Lamport-Robotics/pincer1/brain/corpus/fixtures/gpl/copyleft.md

# A copyleft document

This file is listed under a GPL-3.0 source and must never appear in the output, whatever it
says about scams, phishing, wallets or anything else. The collector reports the skip by licence
and moves on. It is long enough to pass the length filter and English enough to pass the
language filter, which is the point: only the licence keeps it out of the corpus.
