Lamport-Robotics/pincer1/brand/display-800x480.png

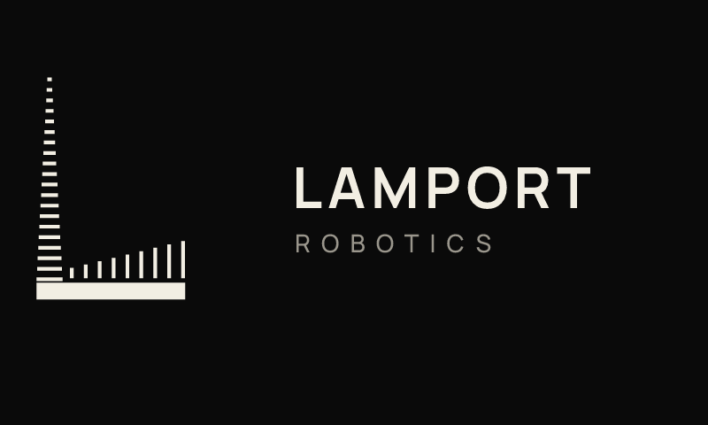
brand/display-800x480.png
