Lamport-Robotics/pincer1/brand/mark-128.png

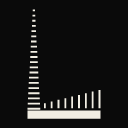
brand/mark-128.png
