Lamport-Robotics/pincer1/brand/og-1200x630.png

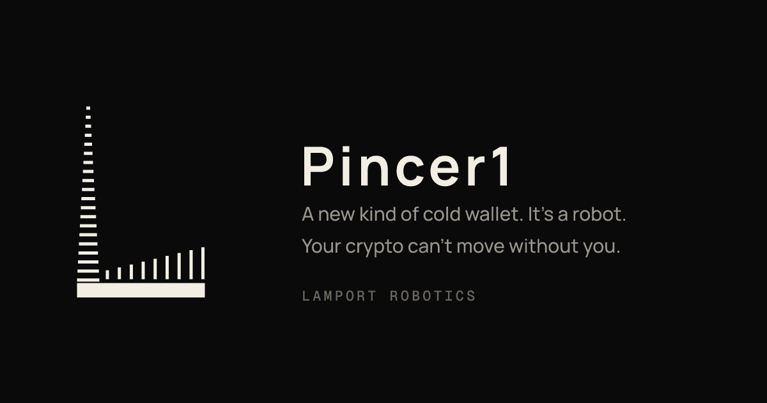
brand/og-1200x630.png
