Lamport-Robotics/pincer1/cad/out/battery_tray.png

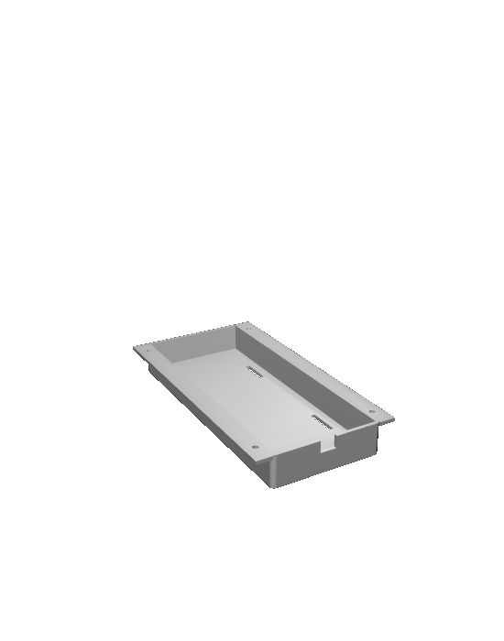
cad/out/battery_tray.png
