Lamport-Robotics/pincer1/cad/out/bottom_plate.png

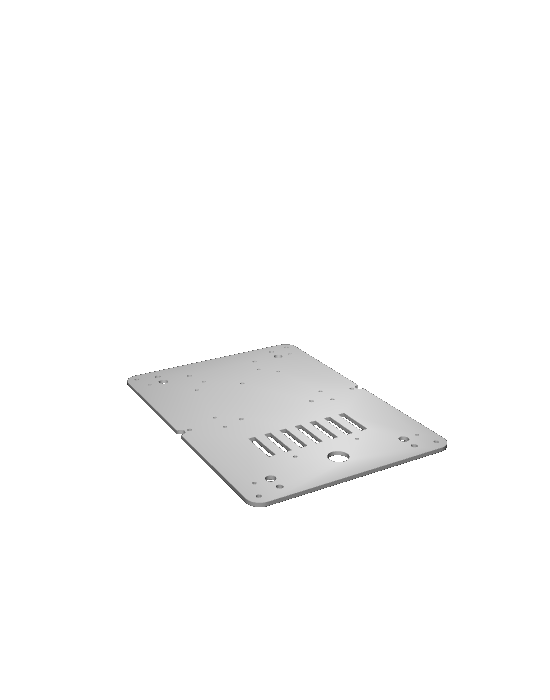
cad/out/bottom_plate.png
