Lamport-Robotics/pincer1/cad/out/camera_bracket.png

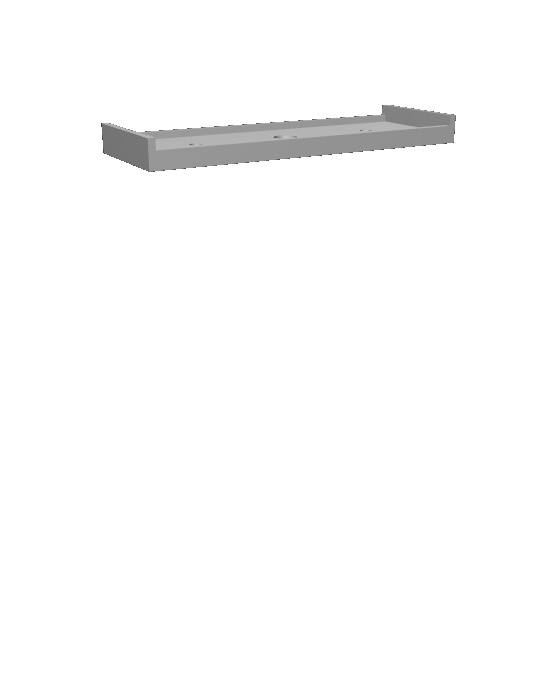
cad/out/camera_bracket.png
