Lamport-Robotics/pincer1/cad/out/coxa_bracket.png

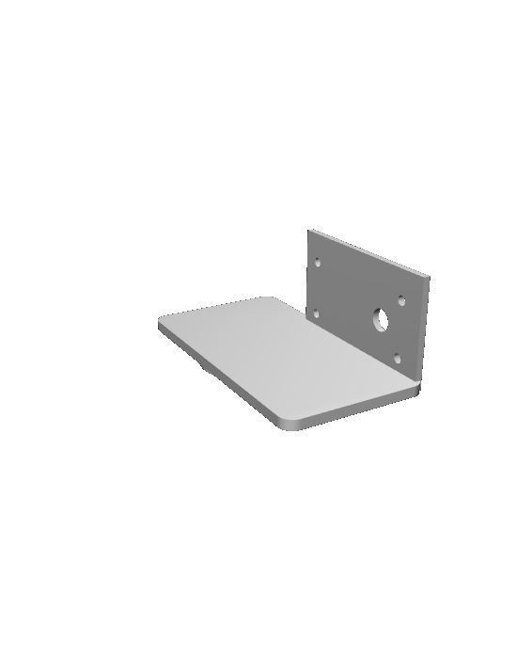
cad/out/coxa_bracket.png
