Lamport-Robotics/pincer1/cad/out/femur_link.png

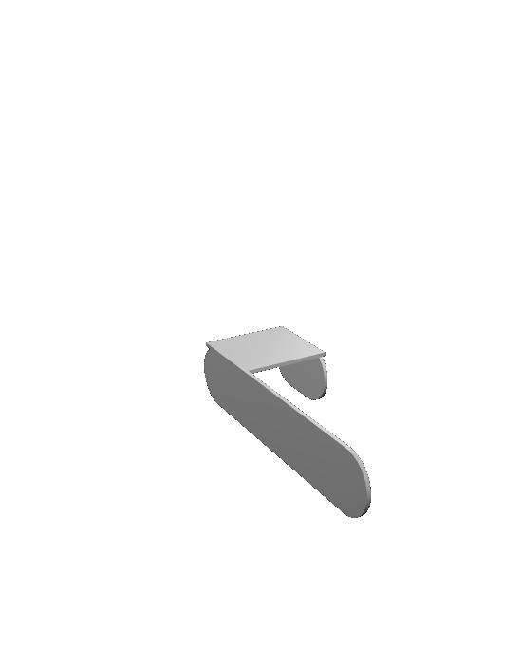
cad/out/femur_link.png
