Lamport-Robotics/pincer1/cad/out/front_bezel.png

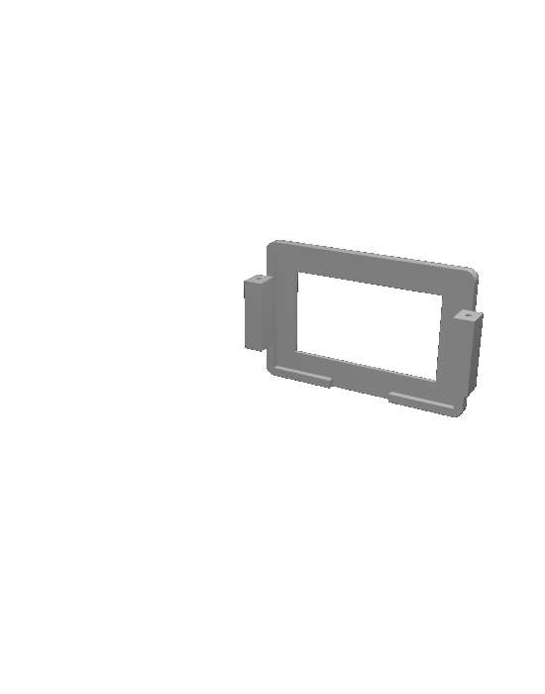
cad/out/front_bezel.png
