Lamport-Robotics/pincer1/cad/out/head_housing.png

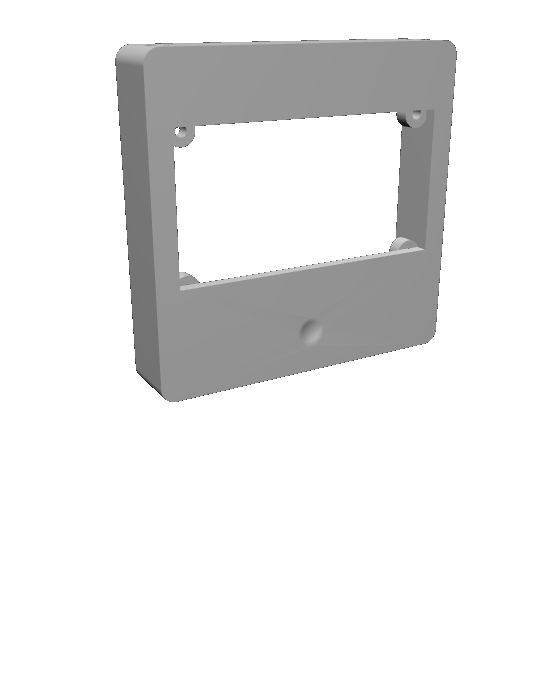
cad/out/head_housing.png
