Lamport-Robotics/pincer1/cad/out/tibia_link.png

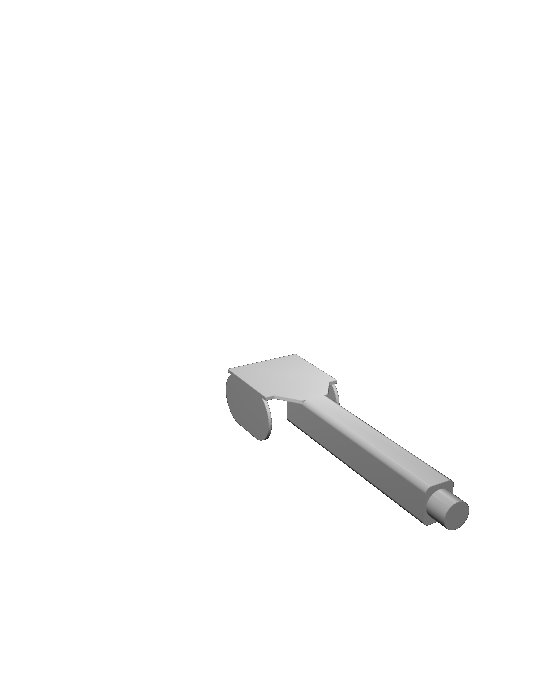
cad/out/tibia_link.png
