Lamport-Robotics/pincer1/cad/out/top_plate.png

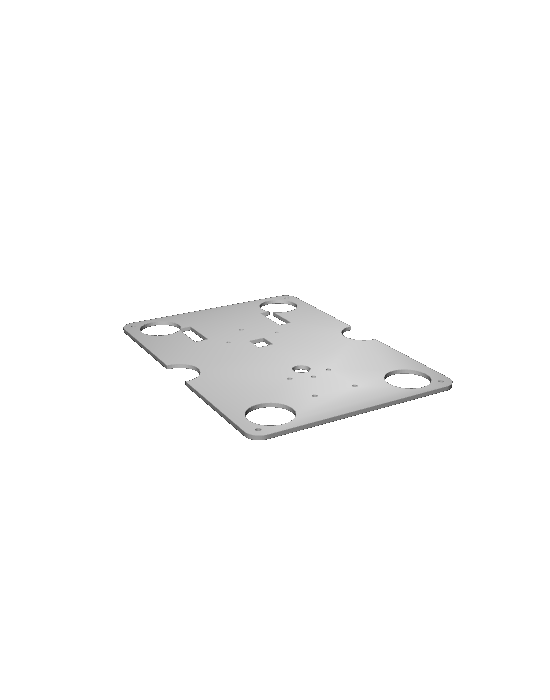
cad/out/top_plate.png
