Lamport-Robotics/pincer1/cad/out/wrist_adapter.png

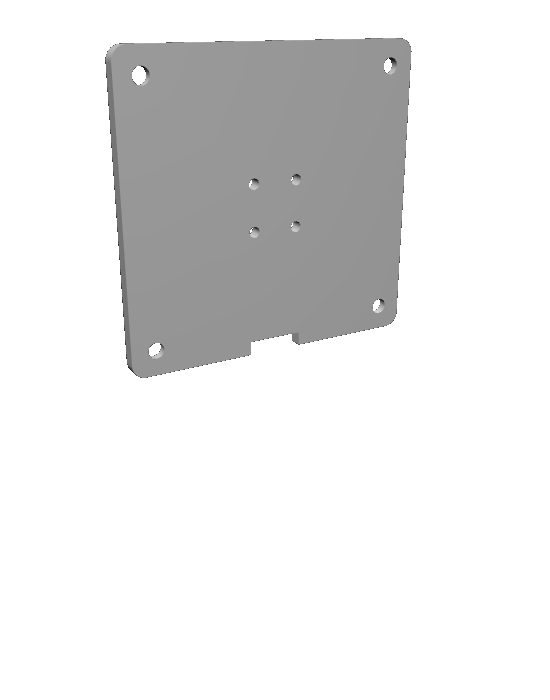
cad/out/wrist_adapter.png
