Lamport-Robotics/pincer1/sim/pincer1.png

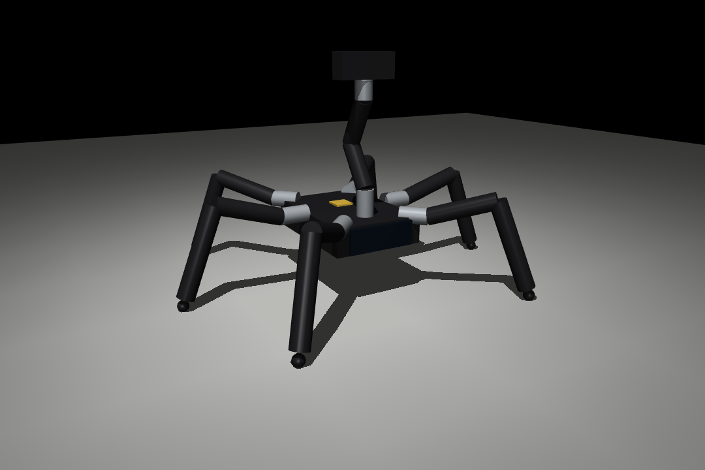
sim/pincer1.png
