Lamport-Robotics/pincer1/sim/stairs.gif

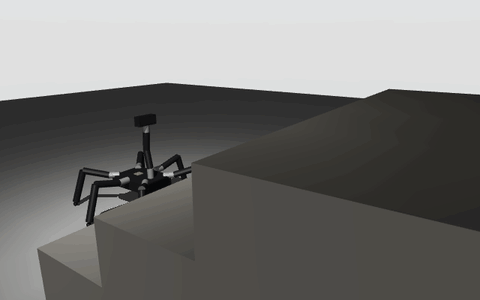
sim/stairs.gif
