Lamport-Robotics/pincer1/cad/out/bottom_plate.step

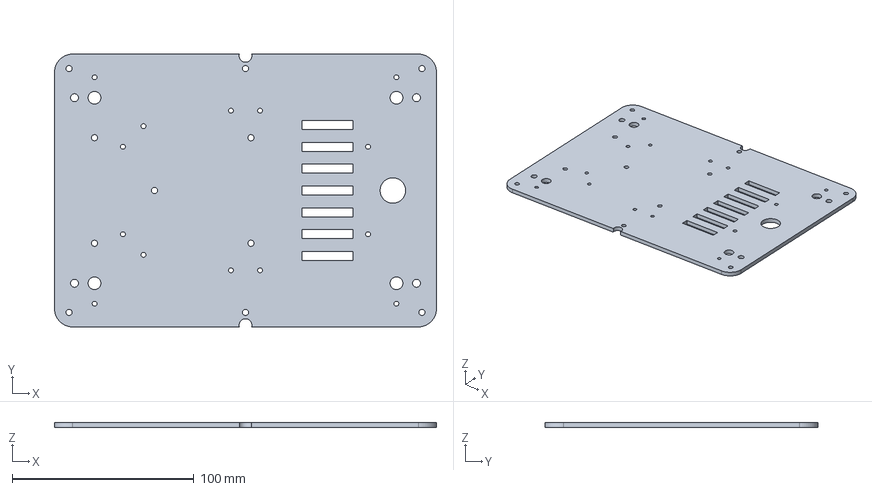
[picture p19: CAD file, 2026-11-01]
cad/out/bottom_plate.step
210.0 x 150.0 x 3.00 mm
