Lamport-Robotics/pincer1/cad/out/coxa_bracket.step

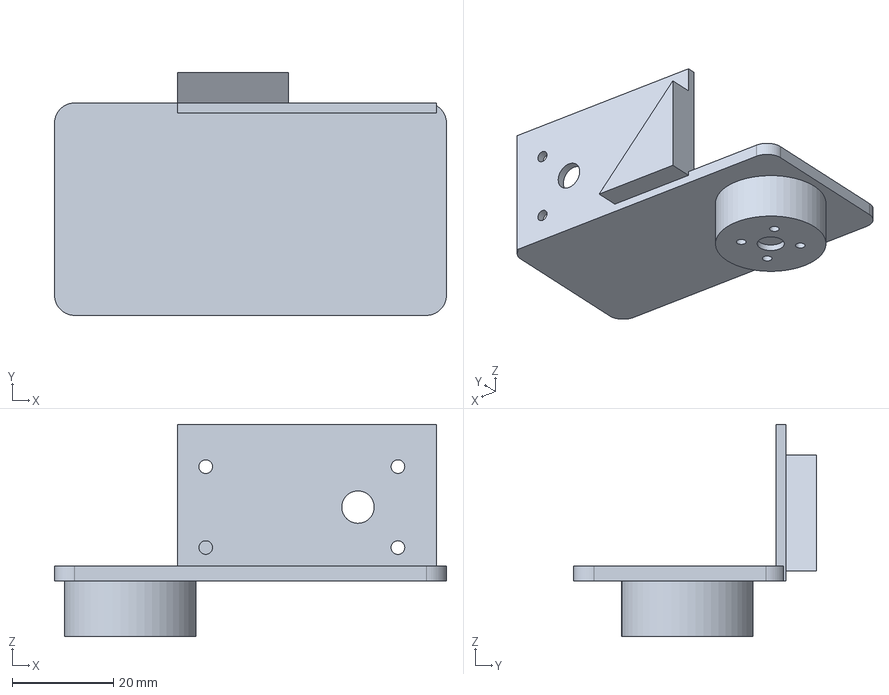
[picture p20: CAD file, 2026-11-01]
cad/out/coxa_bracket.step
77.5 x 48.0 x 42.0 mm
