Lamport-Robotics/pincer1/cad/out/top_plate.step

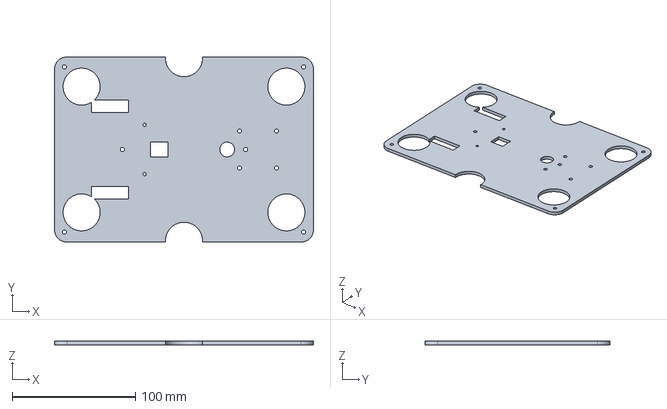
[picture p21: CAD file, 2026-11-01]
cad/out/top_plate.step
210.0 x 150.0 x 3.00 mm
