Lamport-Robotics/pincer1/cad/out/tibia_link.step

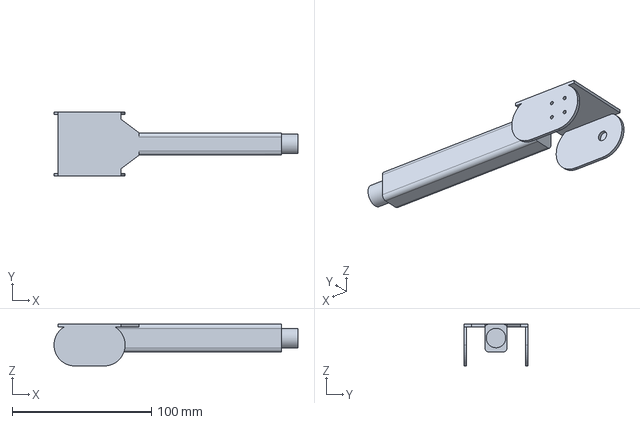
[picture p22: CAD file, 2026-11-01]
cad/out/tibia_link.step
175.0 x 46.0 x 30.0 mm
