Lamport-Robotics/pincer1/cad/out/femur_link.step

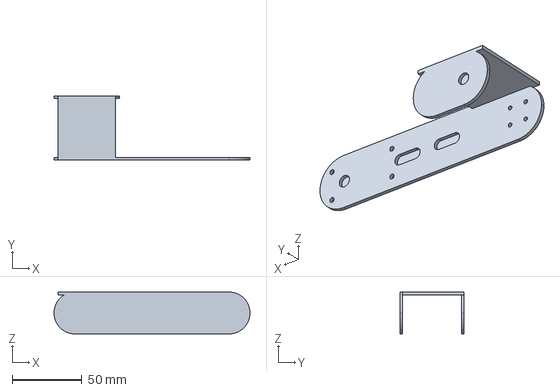
[picture p23: CAD file, 2026-11-01]
cad/out/femur_link.step
140.5 x 46.0 x 30.0 mm
