Lamport-Robotics/pincer1/cad/out/battery_tray.step

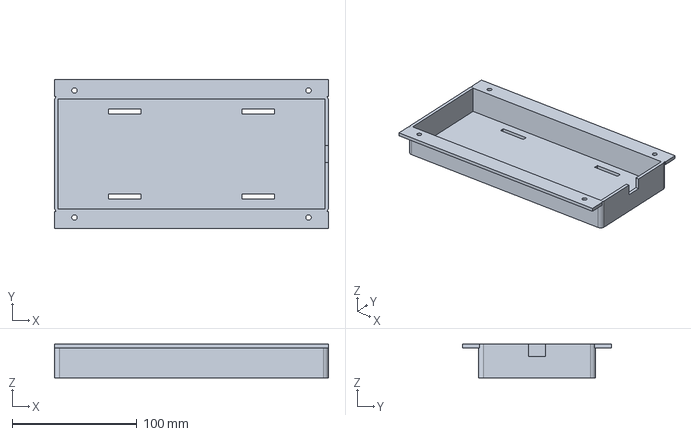
[picture p24: CAD file, 2026-11-01]
cad/out/battery_tray.step
220.0 x 120.0 x 27.0 mm
