Lamport-Robotics/pincer1/cad/out/front_bezel.step

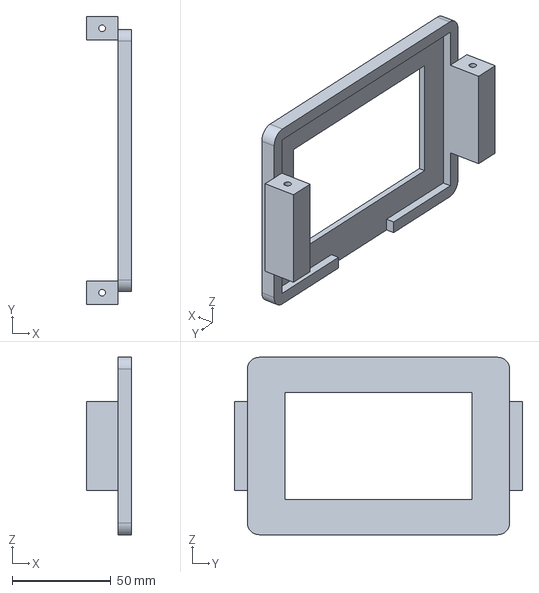
[picture p25: CAD file, 2026-11-01]
cad/out/front_bezel.step
23.0 x 146.0 x 90.0 mm
