Lamport-Robotics/pincer1/cad/out/camera_bracket.step

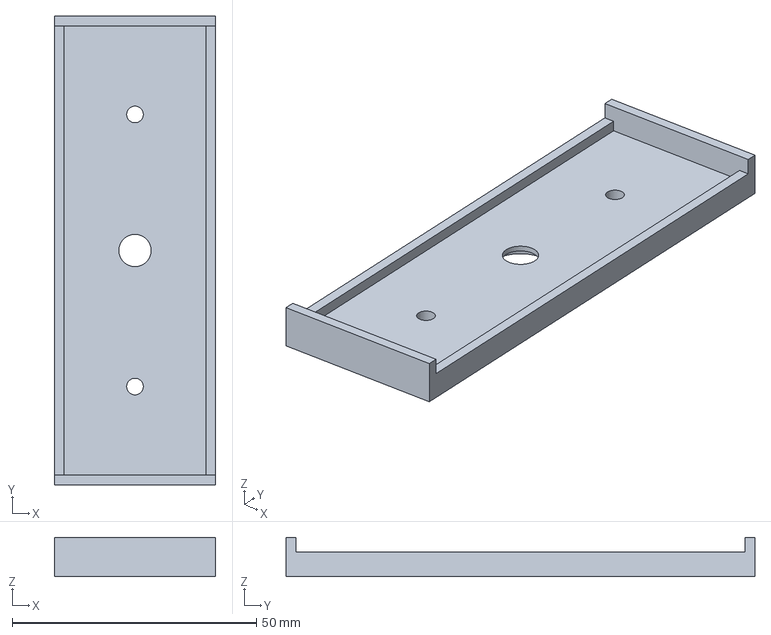
[picture p26: CAD file, 2026-11-01]
cad/out/camera_bracket.step
33.0 x 96.0 x 8.00 mm
