Lamport-Robotics/pincer1/cad/out/head_housing.step

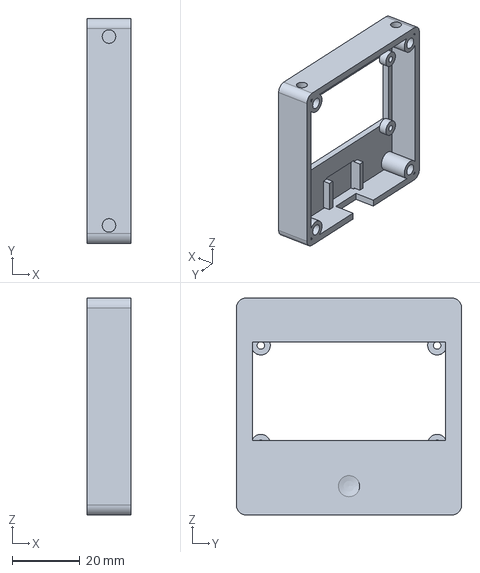
[picture p27: CAD file, 2026-11-01]
cad/out/head_housing.step
13.1 x 66.5 x 64.0 mm
