Lamport-Robotics/pincer1/cad/out/wrist_adapter.step

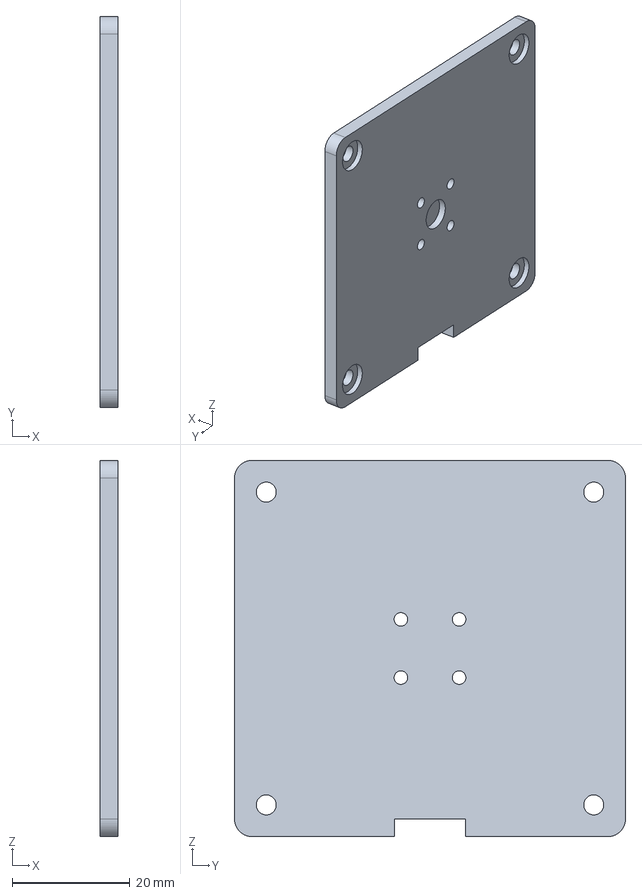
[picture p28: CAD file, 2026-11-01]
cad/out/wrist_adapter.step
3.00 x 66.5 x 64.0 mm
