Lamport-Robotics/pincer1/(list of files, cad)

Other CAD files:
cad/out/tibia_link_plate.dxf
cad/out/femur_link_plate.dxf
cad/out/battery_tray.stl
cad/out/bottom_plate.dxf
cad/out/bottom_plate.stl
cad/out/camera_bracket.stl
cad/out/coxa_bracket.stl
cad/out/femur_link.stl
cad/out/front_bezel.stl
cad/out/head_housing.stl
cad/out/tibia_link.stl
cad/out/top_plate.dxf
cad/out/top_plate.stl
cad/out/wrist_adapter.stl
