Lamport-Robotics/pincer1/cad/out/body_assembly.png

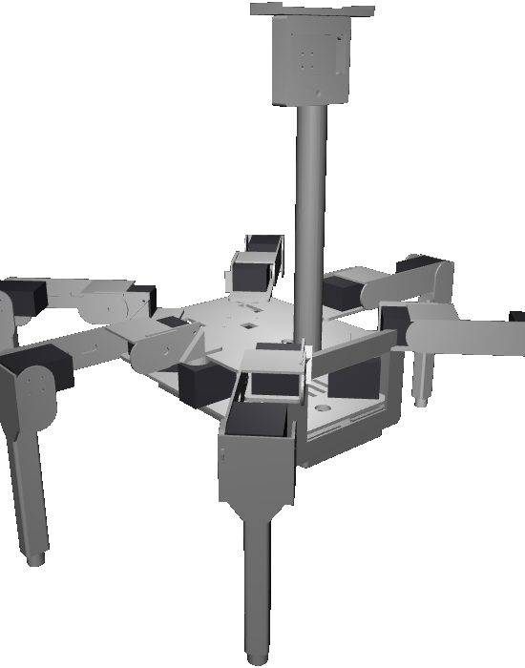
cad/out/body_assembly.png
