Lamport-Robotics/pincer1/cad/out/head_assembly.png

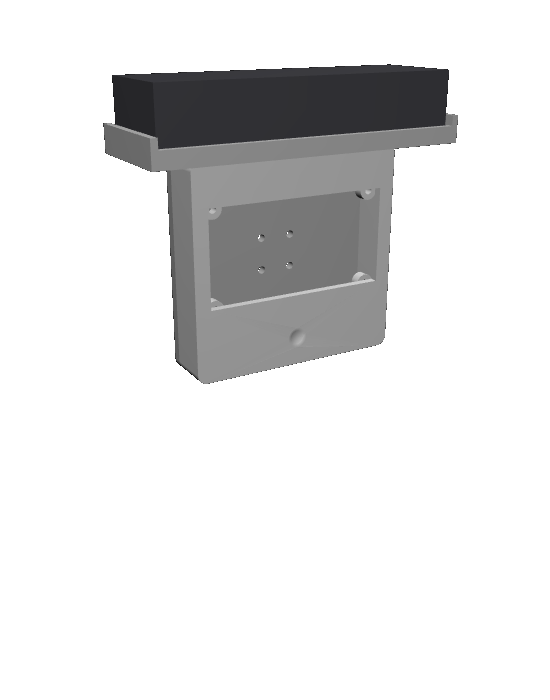
cad/out/head_assembly.png
