Lamport-Robotics/pincer1/robot/pincer_robot/body/controller.py

"""The body controller: velocity in, servo packets out, at a fixed tick.

``Body`` owns the geometry, the gait and the pose, and turns a ``Velocity`` command into joint
angles
for the eighteen leg servos. ``tick(dt)`` is the only thing that moves anything. Whatever drives the
servos (a ``Bus`` on the real body, a ``Simulation`` without one) is injected, so the same
controller
runs in tests, on a bench with a single leg, and on the robot.

``BodyBackend`` plugs this into the ``RobotInterface`` the rest of the service already uses
(walk / turn / attention / idle sway), replacing the external gait controller that backend talked
to.
"""

from __future__ import annotations

import logging
import math
import threading
import time
from collections.abc import Callable
from dataclasses import dataclass, field
from typing import Protocol

from ..motion import GAIT_SPEED_MPS, TURN_RATE_DPS, RobotInterface, RobotStatus
from .gait import GaitParams, GaitState, Velocity, feet_down, step
from .geometry import BodyGeometry
from .kinematics import BodyPose, JointAngles, ReachError, Vec3, solve_body
from .servo import Bus, ServoError
from .sim import Simulation

log = logging.getLogger("pincer.body")

TICK_HZ = 50.0


class Actuator(Protocol):
    """Where joint angles go. ``Bus.move`` on hardware; ``Simulation.apply`` without it."""

    def apply(self, angles: list[JointAngles]) -> None: ...


class BusActuator:
    """Maps the six legs' angles to servo ids and sends one sync-write per tick."""

    def __init__(self, bus: Bus, geometry: BodyGeometry, move_time_ms: int = 0):
        self.bus, self.geometry, self.move_time_ms = bus, geometry, move_time_ms

    def servo_ids(self) -> list[int]:
        return [sid for leg in range(6) for sid in self.geometry.servo_ids(leg)]

    def apply(self, angles: list[JointAngles]) -> None:
        targets: dict[int, float] = {}
        for leg, a in enumerate(angles):
            c, f, t = self.geometry.servo_ids(leg)
            targets[c], targets[f], targets[t] = a.coxa, a.femur, a.tibia
        self.bus.move(targets, time_ms=self.move_time_ms)

    def torque(self, on: bool) -> None:
        self.bus.torque(self.servo_ids(), on)


@dataclass
class Body:
    geometry: BodyGeometry = field(default_factory=BodyGeometry)
    gait: GaitParams = field(default_factory=GaitParams)
    actuator: Actuator | None = None
    pose: BodyPose = field(default_factory=BodyPose)
    command: Velocity = field(default_factory=Velocity)
    state: GaitState = field(default_factory=GaitState)
    sit_height_m: float = 0.035
    angles: list[JointAngles] = field(default_factory=list)
    feet: list[Vec3] = field(default_factory=list)
    _height: float | None = None

    def __post_init__(self) -> None:
        if self._height is None:
            self._height = self.geometry.stance_height_m

    # --- commands -----------------------------------------------------------------------
    def set_velocity(self, vx: float, vy: float = 0.0, wz: float = 0.0) -> None:
        self.command = Velocity(vx, vy, wz)

    def stop(self) -> None:
        self.command = Velocity()

    def set_pose(self, pose: BodyPose) -> None:
        self.pose = pose

    def set_height(self, height_m: float) -> None:
        lo, hi = self.sit_height_m, self.geometry.reach_m * 0.8
        self._height = max(lo, min(hi, height_m))

    # --- the tick -----------------------------------------------------------------------
    def targets(self, dt: float) -> list[JointAngles]:
        """Advance the gait by ``dt`` and compute the joint angles, without sending them."""
        feet = step(self.geometry, self.state, self.command, self.gait, dt)
        dz = self.geometry.stance_height_m - (self._height or self.geometry.stance_height_m)
        feet = [(x, y, z + dz) for x, y, z in feet]
        self.feet = feet
        self.angles = solve_body(self.geometry, feet, self.pose)
        return self.angles

    def tick(self, dt: float = 1.0 / TICK_HZ) -> list[JointAngles]:
        angles = self.targets(dt)
        if self.actuator is not None:
            self.actuator.apply(angles)
        return angles

    def feet_down(self) -> list[bool]:
        return feet_down(self.state, self.gait)

    def stand(self, seconds: float = 1.0, actuate: bool = True) -> None:
        """Rise from wherever the legs are to the neutral stance over ``seconds``."""
        self.stop()
        self.set_height(self.geometry.stance_height_m)
        self._settle(seconds, actuate)

    def sit(self, seconds: float = 1.0, actuate: bool = True) -> None:
        self.stop()
        self.set_height(self.sit_height_m)
        self._settle(seconds, actuate)

    def _settle(self, seconds: float, actuate: bool) -> None:
        n = max(1, int(seconds * TICK_HZ))
        for _ in range(n):
            self.tick(1.0 / TICK_HZ) if actuate else self.targets(1.0 / TICK_HZ)
            if actuate and self.actuator is not None:
                time.sleep(1.0 / TICK_HZ)


@dataclass
class HealthReport:
    hottest_c: int = 0
    heaviest_load: int = 0
    unreadable: list[int] = field(default_factory=list)
    over: list[str] = field(default_factory=list)  # "servo 7 at 74 C", "servo 12 load 910"

    @property
    def ok(self) -> bool:
        return not self.over


class ServoHealth:
    """Temperature and load of every joint, read over the bus between gait ticks. Past a
    threshold the body is put in cooldown: nothing walks until it expires, and the reason is
    logged once per episode rather than on every poll."""

    def __init__(
        self,
        bus: Bus,
        servo_ids: list[int],
        *,
        max_temp_c: int = 70,
        max_load: int = 800,
        cooldown_s: float = 30.0,
        clock=time.monotonic,
    ):
        self.bus, self.ids = bus, list(servo_ids)
        self.max_temp_c, self.max_load, self.cooldown_s = max_temp_c, max_load, cooldown_s
        self._clock = clock
        self.cooldown_until = 0.0
        self.last: HealthReport = HealthReport()
        self._announced = False

    def check(self) -> HealthReport:
        r = HealthReport()
        for sid in self.ids:
            try:
                t = self.bus.temperature(sid)
                ld = abs(self.bus.load(sid))
            except ServoError:
                r.unreadable.append(sid)
                continue
            r.hottest_c = max(r.hottest_c, t)
            r.heaviest_load = max(r.heaviest_load, ld)
            if t >= self.max_temp_c:
                r.over.append(f"servo {sid} at {t} C")
            if ld >= self.max_load:
                r.over.append(f"servo {sid} load {ld}")
        self.last = r
        if r.over:
            self.cooldown_until = self._clock() + self.cooldown_s
            if not self._announced:
                log.warning("body: %s; resting %.0f s", ", ".join(r.over), self.cooldown_s)
                self._announced = True
        elif self._announced and not self.in_cooldown():
            log.info("body: servos back within limits")
            self._announced = False
        if len(r.unreadable) == len(self.ids) and self.ids:
            log.warning("body: no servo answered the health poll")
        return r

    def in_cooldown(self) -> bool:
        return self._clock() < self.cooldown_until


class SensorSource(Protocol):
    """Where tilt and clearance come from when the gait is ours (ros_backend.SensorNode)."""

    def shutdown(self) -> None: ...


class BodyBackend(RobotInterface):
    """The service's robot: drives ``Body`` from the normalised Twist the motion layer produces.
    ``status`` is shared with the sensor source, which writes tilt and front clearance into it;
    ``health`` gates every drive on the last servo poll."""

    def __init__(
        self,
        body: Body,
        status: RobotStatus | None = None,
        *,
        sensors: SensorSource | None = None,
        health: ServoHealth | None = None,
        drive: Callable[[float, float, float], None] | None = None,
    ):
        self.body = body
        self._status = status or RobotStatus(note="body: own gait")
        self.sensors = sensors
        self.health = health
        # a locomotion controller that is not ours (the chassis' own gait): (lin_x, ang_z, seconds)
        self.drive_fn = drive
        self._lock = threading.Lock()
        self._moving = False
        self._poll: threading.Thread | None = None
        self._poll_stop = threading.Event()

    def get_status(self) -> RobotStatus:
        self._status.is_moving = self._moving
        return self._status

    # --- health -------------------------------------------------------------------------
    def start_health_poll(self, period_s: float) -> None:
        if self.health is None or period_s <= 0 or self._poll is not None:
            return
        self._poll = threading.Thread(target=self._poll_loop, args=(period_s,), daemon=True)
        self._poll.start()

    def _poll_loop(self, period_s: float) -> None:
        while not self._poll_stop.wait(period_s):
            with self._lock:  # never interleave reads with a gait tick's sync-write
                self.health.check()  # type: ignore[union-attr]

    def resting(self) -> str | None:
        """Why the body will not walk right now, or None."""
        if self.health is not None and self.health.in_cooldown():
            return "; ".join(self.health.last.over) or "servo cooldown"
        return None

    def shutdown(self) -> None:
        self._poll_stop.set()
        self.stop()
        if self.sensors is not None:
            self.sensors.shutdown()

    def _drive(self, lin_x: float, ang_z: float, duration_s: float) -> None:
        why = self.resting()
        if why is not None:
            log.warning("body: not moving (%s)", why)
            return
        if self.drive_fn is not None:
            with self._lock:
                self._moving = True
                try:
                    self.drive_fn(lin_x, ang_z, duration_s)
                finally:
                    self._moving = False
            return
        with self._lock:
            self._moving = True
            self.body.set_velocity(lin_x * GAIT_SPEED_MPS, 0.0, math.radians(ang_z * TURN_RATE_DPS))
            end = time.monotonic() + duration_s
            period = 1.0 / TICK_HZ
            try:
                while time.monotonic() < end:
                    t0 = time.monotonic()
                    try:
                        self.body.tick(period)
                    except ReachError as e:  # a pose the legs cannot hold: stop rather than fold
                        log.warning("body: %s; stopping", e)
                        break
                    time.sleep(max(0.0, period - (time.monotonic() - t0)))
            finally:
                self.body.stop()
                # let the feet come down before reporting still
                for _ in range(int(self.body.gait.cycle_s * TICK_HZ)):
                    self.body.tick(period)
                    if all(self.body.feet_down()):
                        break
                    time.sleep(period)
                self._moving = False

    def climb(
        self,
        riser_m: float,
        tread_m: float = 0.28,
        steps: int = 1,
        *,
        distance_m: float | None = None,
        yaw_rad: float | None = None,
        sleep: Callable[[float], None] = time.sleep,
    ) -> str:
        """Square up to the first riser, close in to the cycle's standoff, then play the stair
        cycle from ``climb.py`` at the gait tick. Refused with the planner's reason when the
        geometry cannot do the riser, or when the body is resting."""
        from .climb import (
            ClimbError,
            ClimbParams,
            Terrain,
            angles_at,
            climb_cycle,
            duration,
            interpolate,
        )

        why = self.resting()
        if why is not None:
            return f"REFUSED: not climbing ({why})."
        if self._status.tilt_deg > 10.0:
            return f"REFUSED: body tilted {self._status.tilt_deg:.0f} deg before the stairs."
        params = ClimbParams(riser_m=riser_m, tread_m=tread_m, steps=max(1, int(steps)))
        try:
            keyframes = climb_cycle(self.body.geometry, params)
        except ClimbError as e:
            return f"REFUSED: {e.phase}: {e.reason}."
        notes: list[str] = []
        if yaw_rad is not None and abs(yaw_rad) > math.radians(3.0):
            notes.append(
                self.turn("left" if yaw_rad > 0 else "right", abs(math.degrees(yaw_rad)), speed=0.4)
            )
        if distance_m is not None:
            gap = distance_m - Terrain(riser_m, tread_m).edge0_m
            if gap > 0.02:
                notes.append(self.walk("forward", gap, speed=0.4))
            elif gap < -0.05:
                notes.append(self.walk("backward", -gap, speed=0.4))
        if any(n.startswith("REFUSED") for n in notes):
            return "; ".join(notes)
        period = 1.0 / TICK_HZ
        with self._lock:
            self._moving = True
            try:
                for feet, pose in interpolate(keyframes, period):
                    t0 = time.monotonic()
                    angles = angles_at(self.body.geometry, feet, pose)
                    self.body.angles = angles
                    if self.body.actuator is not None:
                        self.body.actuator.apply(angles)
                    sleep(max(0.0, period - (time.monotonic() - t0)))
            except ReachError as e:
                self.body.stop()
                return f"STOPPED: {e}"
            finally:
                self._moving = False
        self.body.stop()
        total = steps * riser_m
        return (
            f"OK: climbed {steps} step(s) of {riser_m * 100:.0f} cm, {total * 100:.0f} cm up, "
            f"in {duration(keyframes):.0f} s."
        )

    def stop(self) -> None:
        self.body.stop()
        stop = getattr(self.drive_fn, "__self__", None)
        if stop is not None and hasattr(stop, "stop"):
            stop.stop()
        self._moving = False


def simulated_body(
    geometry: BodyGeometry | None = None, gait: GaitParams | None = None
) -> tuple[Body, Simulation]:
    sim = Simulation(geometry or BodyGeometry())
    body = Body(geometry=sim.geometry, gait=gait or GaitParams(), actuator=sim)
    return body, sim
