Lamport-Robotics/pincer1/firmware/src/consent.c

#include "consent.h"

#include <string.h>

#include "util.h"

#define SECONDS_PER_DAY CONSENT_SECONDS_PER_DAY

static void copy_id(char *dst, const char *id)
{
    size_t n = id ? strlen(id) : 0;
    if (n >= CONSENT_ID_MAX) n = CONSENT_ID_MAX - 1;
    memcpy(dst, id, n);
    dst[n] = 0;
}

static void clear_pending(consent_t *c) { secure_zero(&c->pending, sizeof c->pending); }

static void clear_allowance(consent_t *c)
{
    if (c->p.allowance.active) c->dirty = true;
    memset(&c->p.allowance, 0, sizeof c->p.allowance);
}

/* Exchanges the active slot's limits and counters with the other slot's. Called when duress starts or
 * ends: the decoy slot keeps its own limits, so a policy request behaves the same in both slots. */
static void swap_slot_policy(consent_t *c)
{
    consent_persist_t *p = &c->p;
    uint64_t t64;
    u256_t t256;
    if (!p->duress && !p->shadow_valid) {
        /* first time into duress: the decoy starts with the real slot's limits (a decoy that allows nothing
         * convinces nobody) and a clean day; the owner may change them from inside the decoy later */
        p->shadow.daily_limit = p->daily_limit;
        p->shadow.daily_limit_wei = p->daily_limit_wei;
        p->shadow.daily_limit_sats = p->daily_limit_sats;
        p->shadow.spent_today = 0;
        u256_zero(&p->shadow.spent_today_wei);
        p->shadow.spent_today_sats = 0;
        p->shadow_valid = true;
    }
#define SWAP64(a, b) do { t64 = (a); (a) = (b); (b) = t64; } while (0)
#define SWAP256(a, b) do { t256 = (a); (a) = (b); (b) = t256; } while (0)
    SWAP64(p->daily_limit, p->shadow.daily_limit);
    SWAP64(p->spent_today, p->shadow.spent_today);
    SWAP256(p->daily_limit_wei, p->shadow.daily_limit_wei);
    SWAP256(p->spent_today_wei, p->shadow.spent_today_wei);
    SWAP64(p->daily_limit_sats, p->shadow.daily_limit_sats);
    SWAP64(p->spent_today_sats, p->shadow.spent_today_sats);
#undef SWAP64
#undef SWAP256
    c->dirty = true;
}

static void clear_elevate(consent_t *c) { memset(&c->elevate, 0, sizeof c->elevate); }

static bool time_reached(uint32_t now_ms, uint32_t deadline_ms)
{
    return (int32_t)(now_ms - deadline_ms) >= 0;
}

static consent_result_t deny(consent_reason_t r, consent_reason_t *why)
{
    if (why) *why = r;
    return CONSENT_R_DENIED;
}

void consent_init(consent_t *c, const consent_persist_t *persisted, uint32_t now_ms)
{
    memset(c, 0, sizeof *c);
    if (persisted) c->p = *persisted;
    /* A power cycle must never be a way around a lock: initialised controllers boot locked. */
    c->locked = c->p.initialized;
    c->tick_last_ms = now_ms;
}

void consent_init_inheritance(consent_t *c, const consent_inh_persist_t *persisted)
{
    memset(&c->ih, 0, sizeof c->ih);
    if (persisted) c->ih = *persisted;
    /* Resume, never rewind: the stored value is the floor from now on. */
    if (c->ih.last_touch_powered_seconds > c->ih.powered_seconds)
        c->ih.last_touch_powered_seconds = c->ih.powered_seconds;
    if (c->ih.inh.n_warn > CONSENT_INH_MAX_WARN) c->ih.inh.n_warn = CONSENT_INH_MAX_WARN;
    c->ih_persisted_seconds = c->ih.powered_seconds;
    c->ih_dirty = false;
}

/* ---- dead-man timer ---- */
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
