Lamport-Robotics/pincer1/(commit log)

2026-10-10 robot: lidar/face/voice fusion
2026-10-11 jetson deploy
2026-10-11 dock + battery
2026-10-12 wip: configs, room fingerprint tests
2026-10-14 daemon: pairing reply carries every chain's address
2026-10-20 body: leg geometry and closed-form kinematics
2026-10-20 body: tripod, ripple and wave gaits with per-leg landing on stop
2026-10-20 body: serial-bus servo driver, sync write, calibration
2026-10-20 body: controller at 50 hz, simulator with support-polygon check, backend for the motion layer
2026-10-21 firmware: update engine, staged image + trial ledger
2026-10-21 deploy: signed releases, switch, health check, rollback
2026-10-25 firmware: each key slot keeps its own limits; owner operations answer the same in both slots; storage v7
2026-10-25 robot: no browser on the socket, bounded tasks, map names checked, own speech ignored, duress latch clears, enrolment authenticated and 0600, spoken text kept out of logs
2026-10-27 firmware: flash records sealed with a device-derived mac, host time floor persisted
2026-10-27 extension: no raw tx relay, local fonts only, tighter csp
2026-10-27 beacon: radio arm and disarm still end an alarm
2026-10-27 beacon: pseudonymous packet ids on air, relay commands need a token
2026-10-27 robot: servo temperature and load polled, short replies are errors, lidar and imu from the bus backend
2026-10-27 deps: vitest 5, tsx with a current esbuild
2026-10-31 body: segment lengths and coxa positions as measured on the v1 chassis
2026-10-31 sim: pincer1 as urdf and mjcf, built from geometry.py, stance-checked in mujoco
2026-11-01 presence: face observations carry the frame height, y_norm beside x_norm
2026-11-01 body: gaze, the camera head follows the face and scans when it is gone
2026-11-01 robot: on the bus body the head is raised at start and steered from the presence loop
2026-11-01 docs: the head and the calibration procedure in body.md
2026-11-01 cad: the head as code, housing for the display and the consent pad, camera cradle, wrist adapter
2026-11-01 readme: cad is in here now
2026-11-01 robot: terrain, the floor ahead from the depth camera: height grid, first riser, clearance
2026-11-01 body: climb, a stair cycle from the kinematics: pulls, swings over the riser, body fit with pitch
2026-11-01 sim: stairs.py climbs box steps in mujoco; the 12 cm step as a gif
2026-11-01 body: v1 legs 110 / 160 mm, the length that takes a 17 cm stair; stance and camera height follow
2026-11-01 robot: depth source for the floor ahead, stereo from the head camera or a drawn scene; floor watch thread
2026-11-01 motion: a forward walk is refused where the depth camera says the floor ends
2026-11-01 sim: the shin stops short of the foot ball; the stance check holds with position servos
2026-11-01 body: the long legs walk at 0.30 m/s by default, 0.6 s cycle and 12 cm steps; walk.py sweeps speed and turn
2026-11-01 climb: belly clearance, wider support margin, staged level-out and paced keyframes; 13 cm stairs in mujoco
2026-11-01 docs: walking speed and stairs numbers for the v1 legs
2026-11-01 body: 21 cm plate, front and rear mounts 83 mm from centre, so the nose clears the next riser
2026-11-01 climb: feet 14 cm under the body and 3 cm off the edge; three 17 cm steps in mujoco, as a gif
2026-11-01 docs: the 21 cm body and the 17 cm staircase
2026-11-01 body: joint backend, the gait and the gaze on the first chassis over rosbridge, pulses from a calibration file
2026-11-01 pincer-calibrate: jog each joint to its neutral, answer the direction, write the servo calibration
2026-11-01 readme: the test chassis with its camera arm up; body.md on the first chassis
2026-11-01 robot: one head camera for colour and depth (camera_source=oak)
2026-11-01 cad: the v1 body as code, plates, bezel, battery tray and the three leg brackets
2026-11-01 robot: the first chassis as a body profile, its panel (oled, buzzer, button as the touch), the daemon's display message, a camera stream url, voice through the robot's speaker
2026-11-01 robot: double tap on the body as the touch, face-only enrolment, the chassis preset waits for the user before each nudge
2026-11-01 demo: a plain dapp page, the camera stream reopens after a drop, docs/DEMO.md for the first chassis
2026-11-01 robot: on the chassis the legs walk with its own gait controller over cmd_vel; the head stays ours
2026-11-01 docs: walking on the chassis
2026-11-01 rosbridge: reconnect and resync when the chassis reboots or the link blinks
2026-11-01 robot: idle sway can be switched off
2026-11-01 chassis drive: a stop on start, on interruption and at shutdown, so the gait never runs on
2026-11-01 chassis drive: stop through the gait interface too
2026-11-01 extension: app bar, request sheet, accounts and sites as rows, activity and settings tabs, chain glyphs
2026-11-03 docs: the main computer is the jetson everywhere; pi 5 is a cpu-only fallback, unnamed
2026-11-04 identity: live on peaq (Pincer1Units 0x3e6A…0F9a), fee cap 0.5 PEAQ for 100 gwei mainnet, sim keeps a seed per data dir, PINCER_SERIAL for the bench
2026-11-10 robot: display ttl, inflight cap, nav reasons, front clearance wrap, relay moved check
2026-11-13 signMessage: never sign the Privacy Rings key-derivation message
    A Privacy Rings wallet derives its viewing and nullifier keys from one
    deterministic signature over "TSPP/derive/v1" in a Solana off-chain
    envelope. The controller signs raw bytes for kind "msg", so a site or a
    compromised daemon could send that message with an innocent-looking
    prompt and, after one touch, hold the wallet's privacy keys for good.
    The controller now refuses (denied:policy) any message that contains
    "TSPP/derive/" or SHA-256("TSPP/derive/v1"), the application domain of
    the canonical envelope. The daemon blocks the same bytes before asking
    for a touch and says which site asked; the sim refuses like the
    firmware.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
2026-11-13 signMessage: sign only what the display shows in full; refuse Privacy Rings calls until they are parsed
    The controller refused a "message" only when it parsed as a legacy or v0 Solana
    transaction. A version 1 transaction message (first byte 0x81, live on mainnet)
    is not read by that parser, so kind msg would have signed it after one touch
    behind a screen that showed a byte count and eight hex bytes. The same path
    signed raw 32-byte digests, and the EVM personal_sign path accepted a raw hash.
    Controller (firmware):
    - solmsg_signmsg_check: kind msg signs bare text (bytes 0x20..0x7e or LF, not
    exactly 32 bytes, with a space once it is 32 bytes or longer) or a Solana
    off-chain message, head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
2026-11-13 warden: engine v0, with the owner's payment history in the signing flow
    Warden reads a signature request before it is signed, says in one sentence
    what it will do, and picks how much friction it deserves. This is its engine,
    built on the decoder, scam filter and explainer the daemon already has. No
    model and no network call are involved.
    daemon/src/warden:
    - memory.ts: OwnerMemory. Who the owner has paid, how often and how much.
    Trust grows only through a send the owner confirmed; there is no call for
    inbound transfers, so dust from a look-alike address teaches it nothing.
    - verdict.ts: checkTransaction returns allow, explain, confirm or block, with
    the sentence and the reasons. A des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
